pissnet/piss_stm32/pisspcb.kicad_pcb

## KiCad design pisspcb.kicad_pcb (2021-12-20)

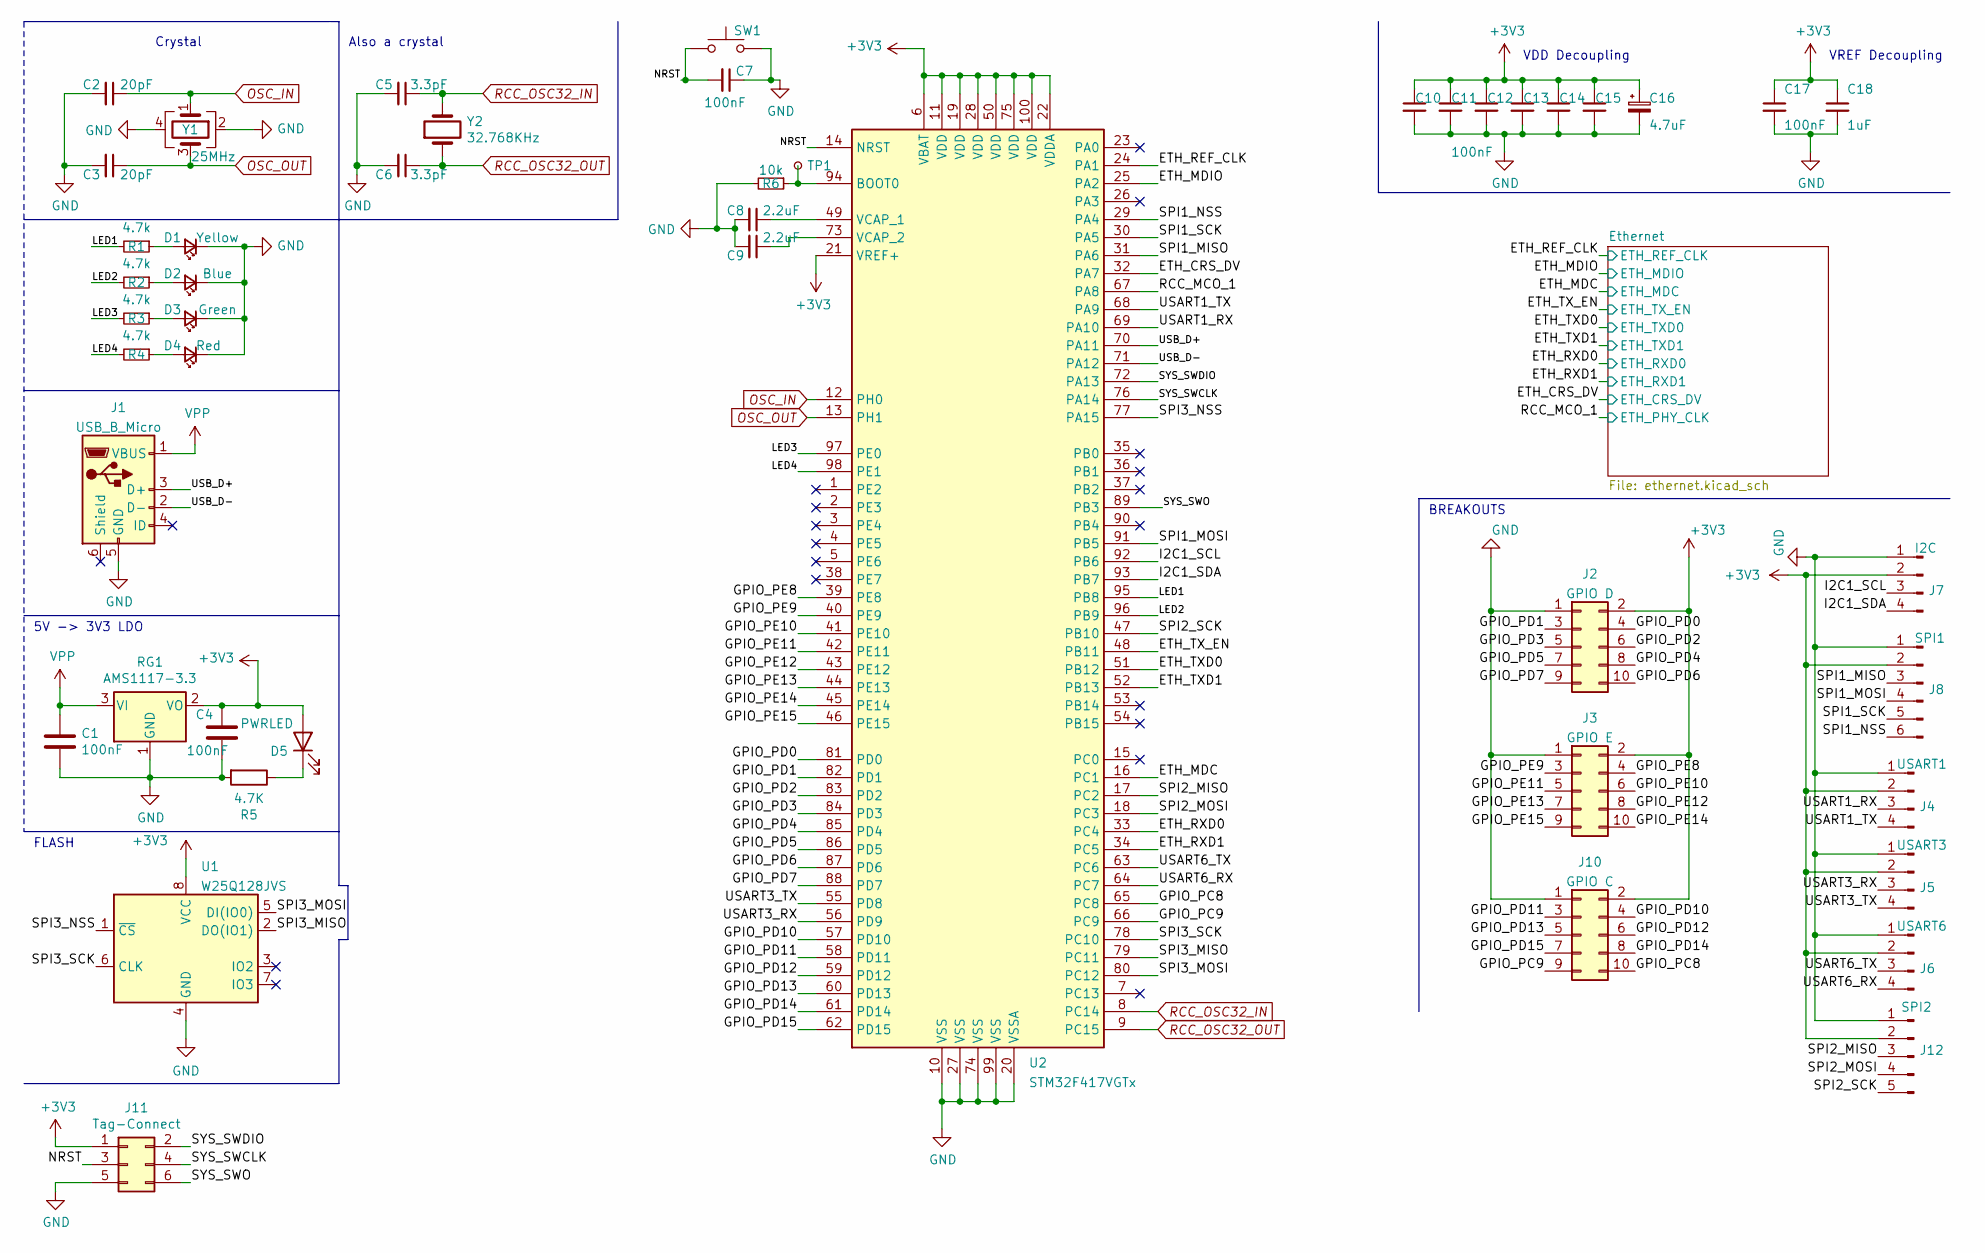
[picture p1: schematic pisspcb.kicad_sch]

Parts:
C1, C4: 100nF; C_0805_2012Metric; LCSC C49678
C2, C3: 20pF; C_0603_1608Metric; LCSC C1648
C5, C6: 3.3pF; C_0402_1005Metric; LCSC C1565
C7, C10, C11, C12, C13, C14, C15, C17: 100nF; C_0603_1608Metric; LCSC C14663
C8, C9: 2.2uF; C_0805_2012Metric; LCSC C49217
C16: 4.7uF; C_0805_2012Metric; LCSC C1779
C18: 1uF; C_0603_1608Metric; LCSC C15849
D1: Yellow; LED_0603_1608Metric; LCSC C72038
D2: Blue; LED_0603_1608Metric; LCSC C72041
D3: Green; LED_0603_1608Metric; LCSC C72043
D4: Red; LED_0603_1608Metric; LCSC C2286
D5: PWRLED; LED_0603_1608Metric; LCSC C2286
J1: USB_B_Micro; USB_Micro-B_Amphenol_10118194_Horizontal; LCSC C132563
J2: GPIO D; PinHeader_2x05_P2.54mm_Vertical
J3: GPIO E; PinHeader_2x05_P2.54mm_Vertical
J4: USART1; PinHeader_1x04_P2.54mm_Vertical
J5: USART3; PinHeader_1x04_P2.54mm_Vertical
J6: USART6; PinHeader_1x04_P2.54mm_Vertical
J7: I2C; PinHeader_1x04_P2.54mm_Vertical
J8: SPI1; PinHeader_1x06_P2.54mm_Vertical
J10: GPIO C; PinHeader_2x05_P2.54mm_Vertical
J11: Tag-Connect; Tag-Connect_TC2030-IDC-FP_2x03_P1.27mm_Vertical
J12: SPI2; PinHeader_1x05_P2.54mm_Vertical
R1, R2, R3, R4: 4.7k; R_0603_1608Metric; LCSC C23162
R5: 4.7K; R_0603_1608Metric; LCSC C23162
R6: 10k; R_0603_1608Metric; LCSC C25804
RG1: AMS1117-3.3; SOT-223-3_TabPin2; LCSC C6186
SW1: SW_Push; SW_SPST_TL3342; LCSC C412370
TP1: BOOT0; TestPoint_Pad_D1.0mm
U1: W25Q128JVS; SOIC-8_5.23x5.23mm_P1.27mm; LCSC C97521
U2: STM32F417VGTx; LQFP-100_14x14mm_P0.5mm
Y1: 25MHz; Crystal_SMD_3225-4Pin_3.2x2.5mm; LCSC C9006
Y2: 32.768KHz; Crystal_SMD_3215-2Pin_3.2x1.5mm; LCSC C32346

Connections:
+3V3: C4.1, C10.1, C11.1, C12.1, C13.1, C14.1, C15.1, C16.1, C17.1, C18.1, D5.2 (A), J2.2, J3.2, J4.2, J5.2, J6.2, J7.2, J8.2, J10.2, J11.1, J12.2, RG1.2 (VO), U1.8 (VCC), U2.6 (VBAT), U2.11 (VDD), U2.19 (VDD), U2.21 (VREF+), U2.22 (VDDA), U2.28 (VDD), U2.50 (VDD), U2.75 (VDD), U2.100 (VDD); also elsewhere on the board
/ETH_CRS_DV: U2.32 (PA7); also elsewhere on the board
/ETH_MDC: U2.16 (PC1); also elsewhere on the board
/ETH_MDIO: U2.25 (PA2); also elsewhere on the board
/ETH_REF_CLK: U2.24 (PA1); also elsewhere on the board
/ETH_RXD0: U2.33 (PC4); also elsewhere on the board
/ETH_RXD1: U2.34 (PC5); also elsewhere on the board
/ETH_TXD0: U2.51 (PB12); also elsewhere on the board
/ETH_TXD1: U2.52 (PB13); also elsewhere on the board
/ETH_TX_EN: U2.48 (PB11); also elsewhere on the board
/GPIO_PC8: J10.10, U2.65 (PC8)
/GPIO_PC9: J10.9, U2.66 (PC9)
/GPIO_PD0: J2.4, U2.81 (PD0)
/GPIO_PD1: J2.3, U2.82 (PD1)
/GPIO_PD2: J2.6, U2.83 (PD2)
/GPIO_PD3: J2.5, U2.84 (PD3)
/GPIO_PD4: J2.8, U2.85 (PD4)
/GPIO_PD5: J2.7, U2.86 (PD5)
/GPIO_PD6: J2.10, U2.87 (PD6)
/GPIO_PD7: J2.9, U2.88 (PD7)
/GPIO_PD10: J10.4, U2.57 (PD10)
/GPIO_PD11: J10.3, U2.58 (PD11)
/GPIO_PD12: J10.6, U2.59 (PD12)
/GPIO_PD13: J10.5, U2.60 (PD13)
/GPIO_PD14: J10.8, U2.61 (PD14)
/GPIO_PD15: J10.7, U2.62 (PD15)
/GPIO_PE8: J3.4, U2.39 (PE8)
/GPIO_PE9: J3.3, U2.40 (PE9)
/GPIO_PE10: J3.6, U2.41 (PE10)
/GPIO_PE11: J3.5, U2.42 (PE11)
/GPIO_PE12: J3.8, U2.43 (PE12)
/GPIO_PE13: J3.7, U2.44 (PE13)
/GPIO_PE14: J3.10, U2.45 (PE14)
/GPIO_PE15: J3.9, U2.46 (PE15)
/I2C1_SCL: J7.3, U2.92 (PB6)
/I2C1_SDA: J7.4, U2.93 (PB7)
/LED1: R1.2, U2.95 (PB8)
/LED2: R2.2, U2.96 (PB9)
/LED3: R3.2, U2.97 (PE0)
/LED4: R4.2, U2.98 (PE1)
/NRST: C7.2, J11.3, SW1.1, U2.14 (NRST)
/RCC_MCO_1: U2.67 (PA8); also elsewhere on the board
/SPI1_MISO: J8.3, U2.31 (PA6)
/SPI1_MOSI: J8.4, U2.91 (PB5)
/SPI1_NSS: J8.6, U2.29 (PA4)
/SPI1_SCK: J8.5, U2.30 (PA5)
/SPI2_MISO: J12.3, U2.17 (PC2)
/SPI2_MOSI: J12.4, U2.18 (PC3)
/SPI2_SCK: J12.5, U2.47 (PB10)
/SPI3_MISO: U1.2 (DO(IO1)), U2.79 (PC11)
/SPI3_MOSI: U1.5 (DI(IO0)), U2.80 (PC12)
/SPI3_NSS: U1.1 (~CS), U2.77 (PA15)
/SPI3_SCK: U1.6 (CLK), U2.78 (PC10)
/SYS_SWCLK: J11.4, U2.76 (PA14)
/SYS_SWDIO: J11.2, U2.72 (PA13)
/SYS_SWO: J11.6, U2.89 (PB3)
/USART1_RX: J4.3, U2.69 (PA10)
/USART1_TX: J4.4, U2.68 (PA9)
/USART3_RX: J5.3, U2.56 (PD9)
/USART3_TX: J5.4, U2.55 (PD8)
/USART6_RX: J6.4, U2.64 (PC7)
/USART6_TX: J6.3, U2.63 (PC6)
/USB_D+: J1.3 (D+), U2.70 (PA11)
/USB_D-: J1.2 (D-), U2.71 (PA12)
GND: C1.2, C2.2, C3.2, C4.2, C5.2, C6.2, C7.1, C8.2, C9.2, C10.2, C11.2, C12.2, C13.2, C14.2, C15.2, C16.2, C17.2, C18.2, D1.1 (K), D2.1 (K), D3.1 (K), D4.1 (K), J1.5 (GND), J2.1, J3.1, J4.1, J5.1, J6.1, J7.1, J8.1, J10.1, J11.5, J12.1, R5.2, R6.2, RG1.1 (GND), SW1.2, U1.4 (GND), U2.10 (VSS), U2.20 (VSSA), U2.27 (VSS), U2.74 (VSS), U2.99 (VSS), Y1.2, Y1.4; also elsewhere on the board
unnamed: C8.1, U2.49 (VCAP_1)
unnamed: C9.1, U2.73 (VCAP_2)
unnamed: D1.2 (A), R1.1
unnamed: D2.2 (A), R2.1
unnamed: D3.2 (A), R3.1
unnamed: D4.2 (A), R4.1
unnamed: D5.1 (K), R5.1
unnamed: R6.1, TP1.1, U2.94 (BOOT0)
OSC_IN: C2.1, U2.12 (PH0), Y1.1
OSC_OUT: C3.1, U2.13 (PH1), Y1.3
RCC_OSC32_IN: C5.1, U2.8 (PC14), Y2.2
RCC_OSC32_OUT: C6.1, U2.9 (PC15), Y2.1
VPP: C1.1, J1.1 (VBUS), RG1.3 (VI)

Notes on the sheet:
Crystal
VREF Decoupling
VDD Decoupling
5V -> 3V3 LDO
Also a crystal
FLASH
BREAKOUTS

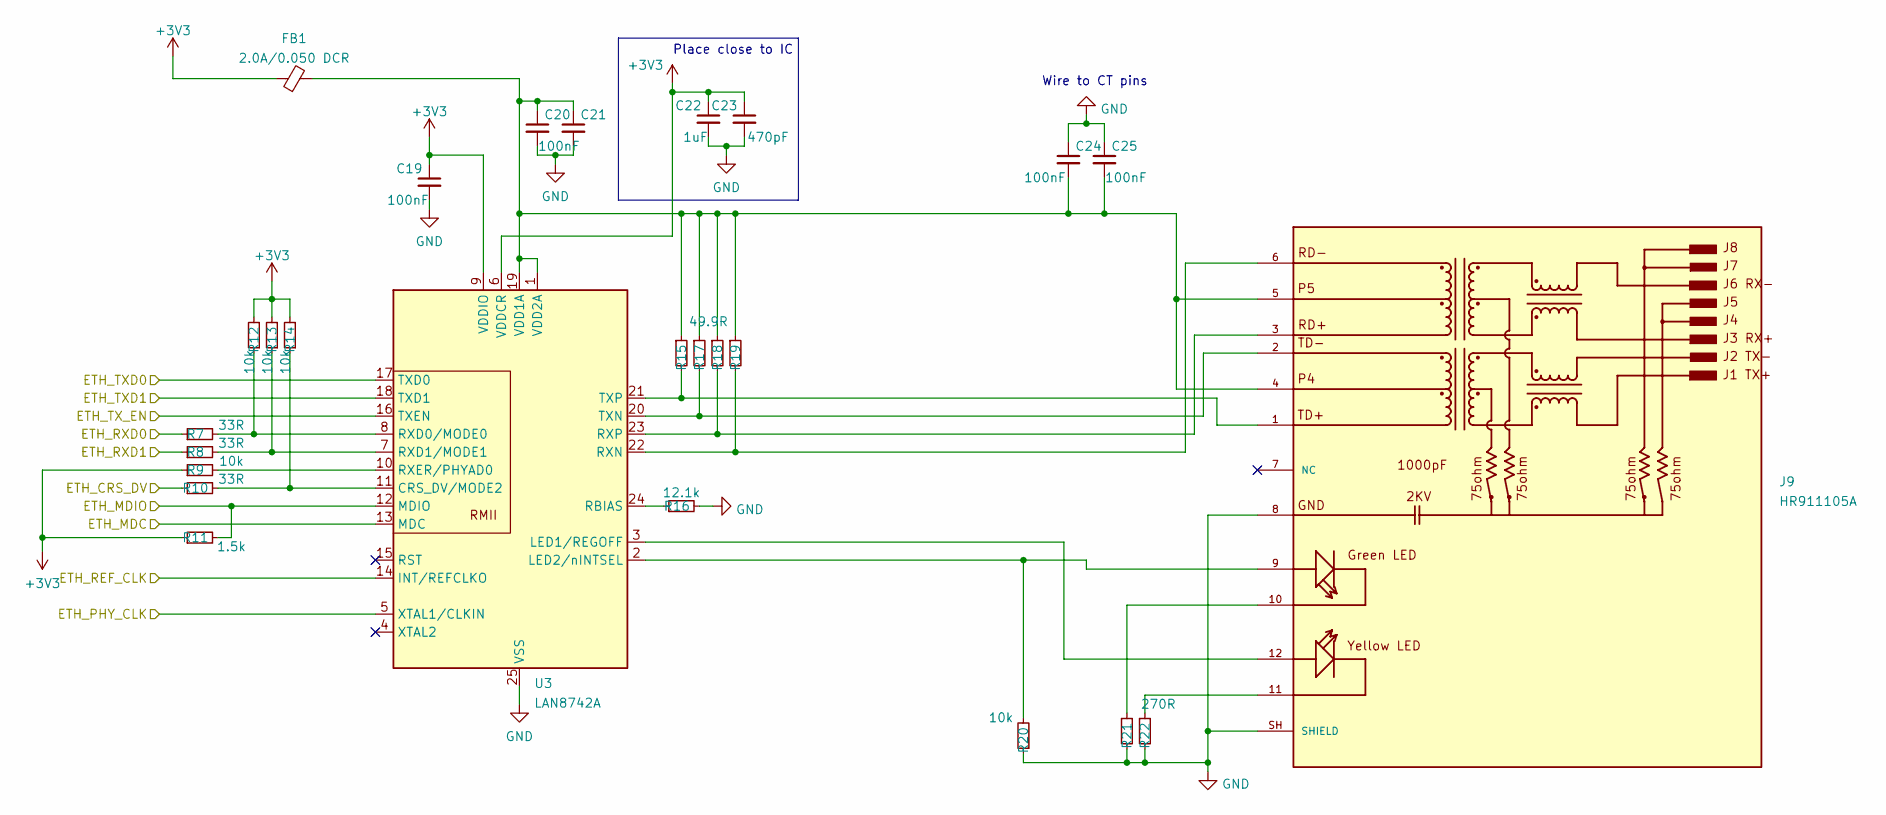
[picture p2: schematic ethernet.kicad_sch]

Parts:
C19, C20, C21, C24, C25: 100nF; C_0603_1608Metric
C22: 1uF; C_0603_1608Metric
C23: 470pF; C_0603_1608Metric
FB1: 2.0A/0.050 DCR; L_0805_2012Metric; LCSC C1015
J9: HR911105A; RJ45_Hanrun_HR911105A; PARTREV A
R7, R8, R10: 33R; R_0603_1608Metric; LCSC C23140
R9, R12, R13, R14, R20: 10k; R_0603_1608Metric
R11: 1.5k; R_0603_1608Metric
R15, R17, R18, R19: 49.9R; R_0603_1608Metric; LCSC C23185
R16: 12.1k; R_0603_1608Metric
R21, R22: 270R; R_0603_1608Metric; LCSC C22966
U3: LAN8742A; QFN-24-1EP_4x4mm_P0.5mm_EP2.6x2.6mm_ThermalVias

Connections:
+3V3: C19.1, C22.1, C23.1, FB1.1, R9.1, R11.1, R12.2, R13.2, R14.2, U3.6 (VDDCR), U3.9 (VDDIO); also elsewhere on the board
/ETH_CRS_DV: R10.1; also elsewhere on the board
/ETH_MDC: U3.13 (MDC); also elsewhere on the board
/ETH_MDIO: R11.2, U3.12 (MDIO); also elsewhere on the board
/ETH_REF_CLK: U3.14 (INT/REFCLKO); also elsewhere on the board
/ETH_RXD0: R7.1; also elsewhere on the board
/ETH_RXD1: R8.1; also elsewhere on the board
/ETH_TXD0: U3.17 (TXD0); also elsewhere on the board
/ETH_TXD1: U3.18 (TXD1); also elsewhere on the board
/ETH_TX_EN: U3.16 (TXEN); also elsewhere on the board
/RCC_MCO_1: U3.5 (XTAL1/CLKIN); also elsewhere on the board
GND: C19.2, C20.2, C21.2, C22.2, C23.2, C24.1, C25.1, J9.8, J9.SH (SHIELD), R16.2, R20.1, R21.2, R22.2, U3.25 (VSS); also elsewhere on the board
unnamed: C20.1, C21.1, C24.2, C25.2, FB1.2, J9.4, J9.5, R15.1, R17.1, R18.1, R19.1, U3.1 (VDD2A), U3.19 (VDD1A)
unnamed: J9.1, R15.2, U3.21 (TXP)
unnamed: J9.2, R17.2, U3.20 (TXN)
unnamed: J9.3, R18.2, U3.23 (RXP)
unnamed: J9.6, R19.2, U3.22 (RXN)
unnamed: J9.9, R20.2, U3.2 (LED2/nINTSEL)
unnamed: J9.10, R21.1
unnamed: J9.11, R22.1
unnamed: J9.12, U3.3 (LED1/REGOFF)
unnamed: R9.2, U3.10 (RXER/PHYAD0)
unnamed: R10.2, R14.1, U3.11 (CRS_DV/MODE2)
unnamed: R7.2, R12.1, U3.8 (RXD0/MODE0)
unnamed: R8.2, R13.1, U3.7 (RXD1/MODE1)
unnamed: R16.1, U3.24 (RBIAS)

Notes on the sheet:
Place close to IC
Wire to CT pins

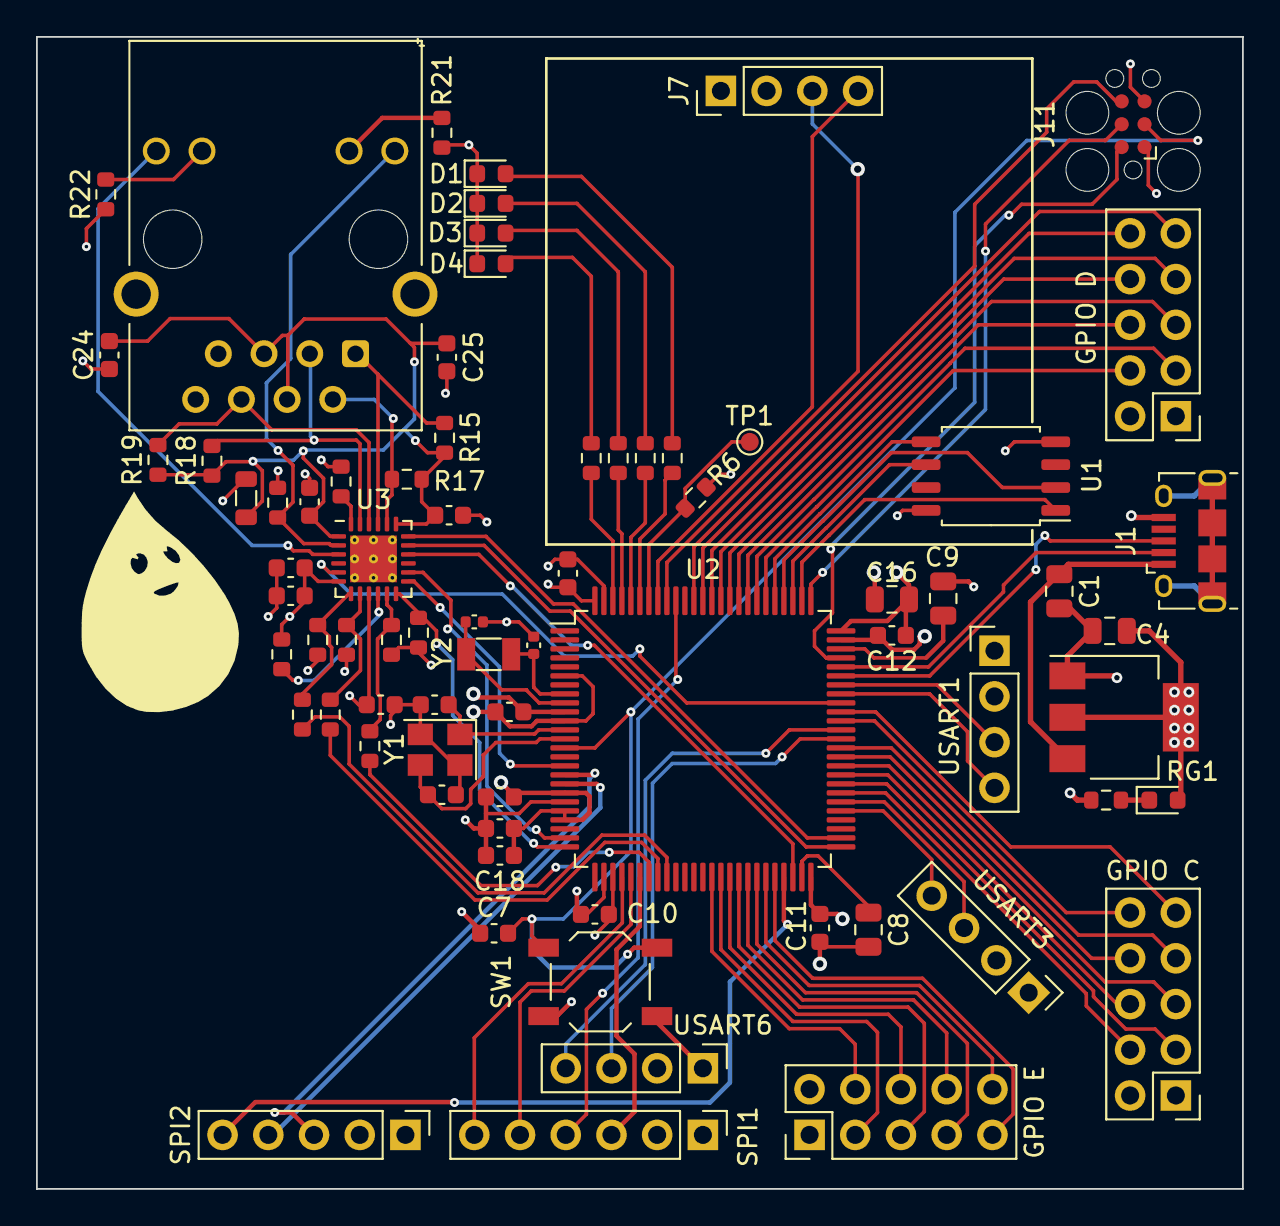
[picture p3: board pisspcb.kicad_pcb from above]

Board: 4 copper layers, 67.0 x 64.0 mm, 73 parts (0 on the bottom side), 92 nets.
